mosTAFAsajID/line-FOLLOWER-obot/Front View.jpg

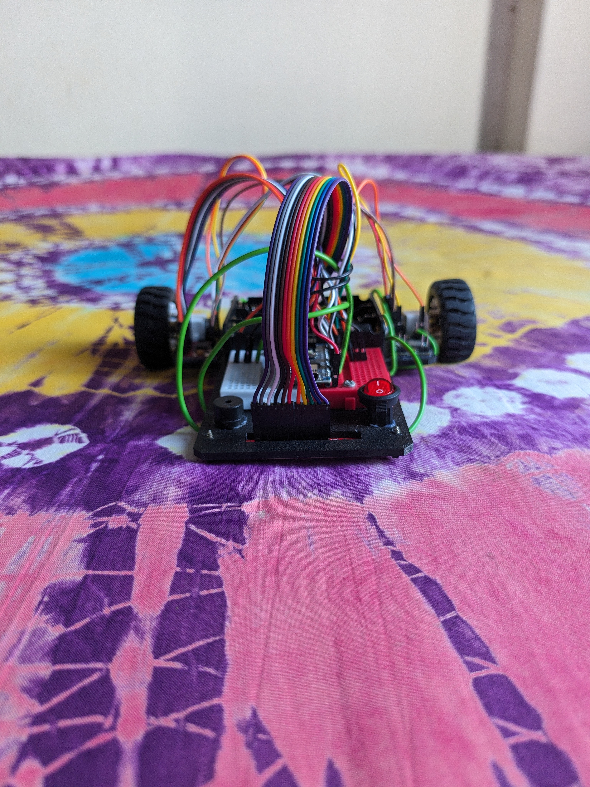
Front View.jpg
