mosTAFAsajID/line-FOLLOWER-obot/Right Side View.jpg

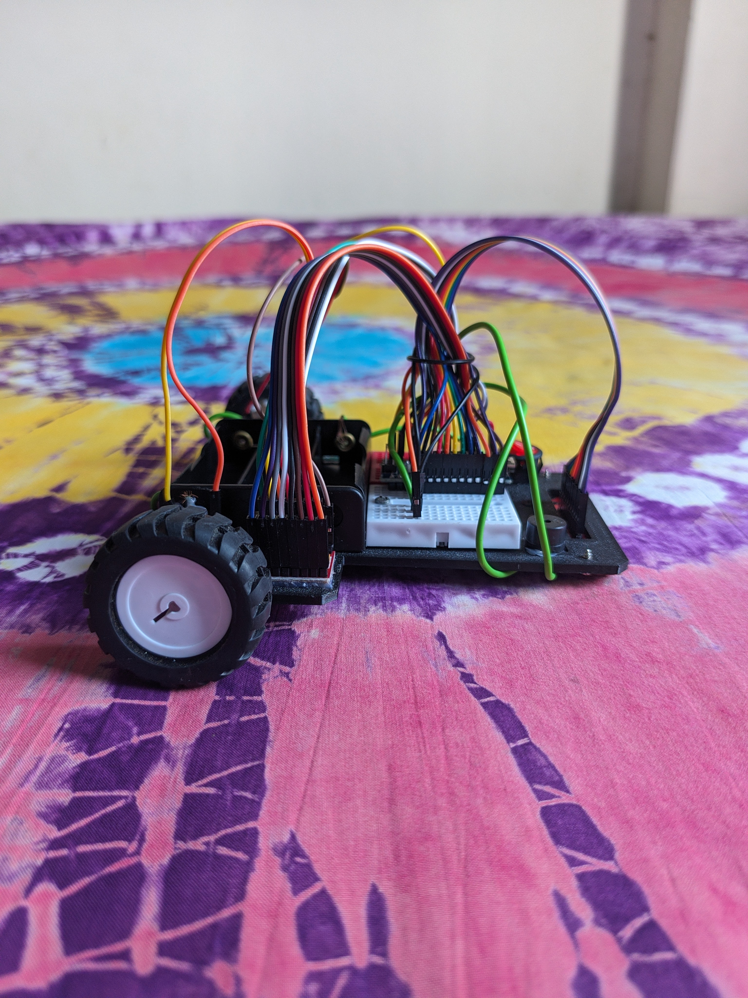
Right Side View.jpg
